mverdon/kicad-library/(commit log)

2024-12-03 add new 8-pin single row generic headers
2024-12-03 fix: sort Connector symbols by alphabetical order
2025-01-04 fix: remove silkscreen on pin header footprints
2025-01-23 add WS2813B-V5 LED
2025-01-24 fix: update LED symbols
2025-02-09 add footprint for FPC pads
2025-02-10 add test point for FPC, add new FPC connector
2025-02-11 add AFA01-S04FCC-00 connector
2025-02-11 add TI switching regulators
2025-02-12 add power inductor ANR5020T5R6M
2025-02-12 add Murata capacitors
2025-03-05 fix: adjust FPC connector footprint
2025-03-05 fix: do not exclude connector from BOM
2025-07-21 feat: add new symbols, new footprints and new 3D models
2025-07-23 feat: add new power inductors
2025-07-24 fix: remove unused footprint
2025-07-28 add JAE MX34024UF1 connector
2025-07-28 add port expander and ADC
